LokiMetaSmith/handheld-scanner/Hardware/Power/STEP files/PinHeader_1x08_P2.54mm_Vertical.step

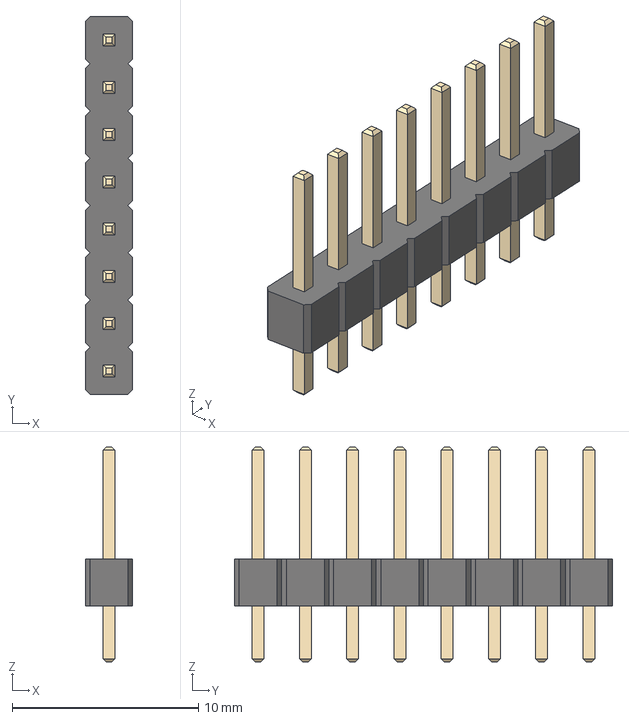
[picture p3: CAD file, 2023-10-03]
Hardware/Power/STEP files/PinHeader_1x08_P2.54mm_Vertical.step
2.54 x 20.3 x 11.5 mm
