LokiMetaSmith/handheld-scanner/Hardware/Power/STEP files/USB4715-GF-A_REVA/USB4715-GF-A_REVA.step

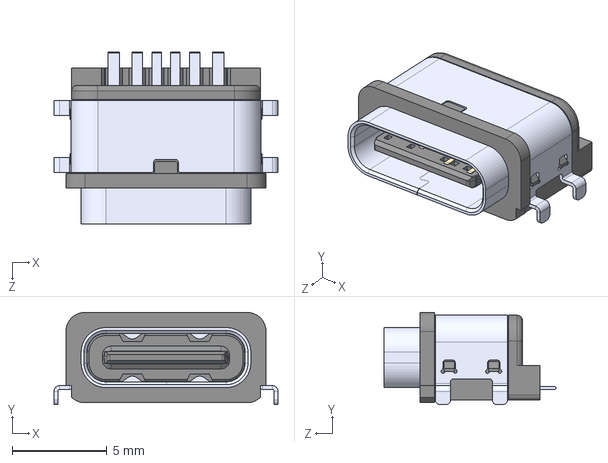
[picture p4: CAD file, 2023-10-03]
Hardware/Power/STEP files/USB4715-GF-A_REVA/USB4715-GF-A_REVA.step
11.8 x 4.86 x 9.05 mm
