LokiMetaSmith/handheld-scanner/Hardware/Power/STEP files/B8B-PH-SM4-TB_LF__SN_.stp

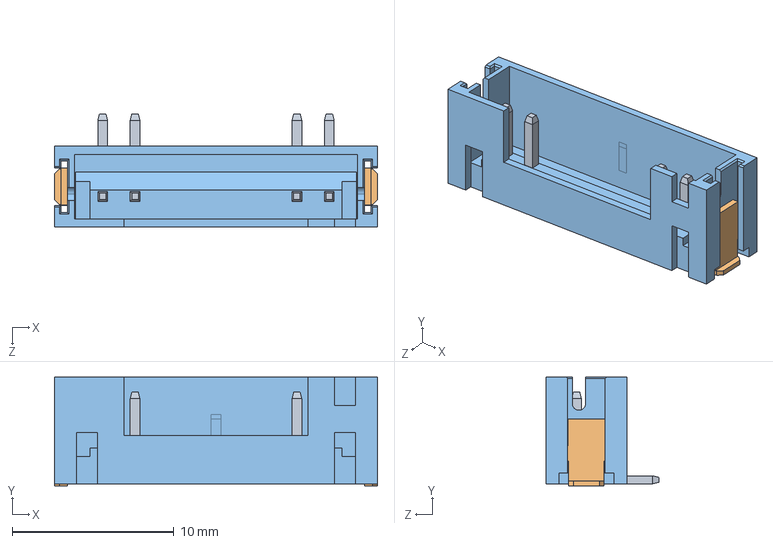
[picture p5: CAD file, 2023-10-03]
Hardware/Power/STEP files/B8B-PH-SM4-TB_LF__SN_.stp
19.9 x 6.73 x 7.00 mm
