LokiMetaSmith/handheld-scanner/Hardware/Power/STEP files/3405 Adafruit HUZZAH32 ESP32 Feather.step

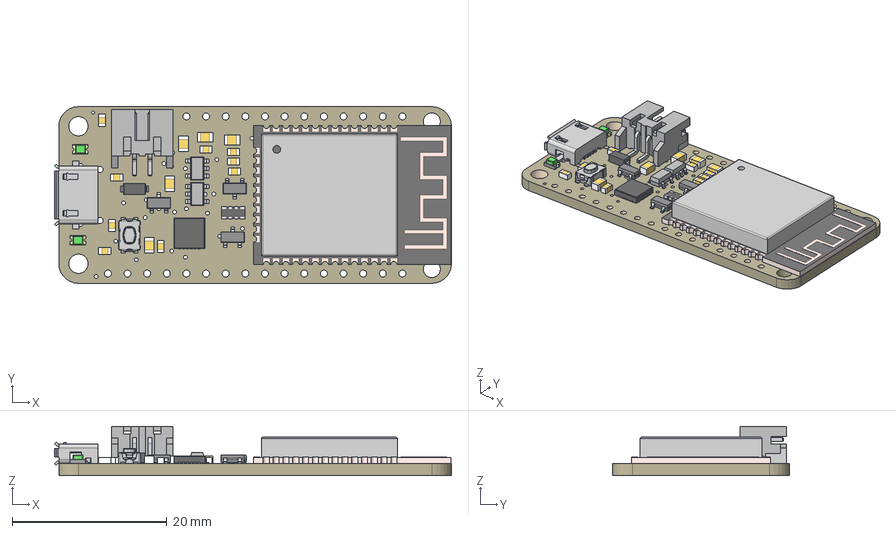
[picture p6: CAD file, 2023-10-03]
Hardware/Power/STEP files/3405 Adafruit HUZZAH32 ESP32 Feather.step
51.4 x 22.9 x 6.37 mm
Board
10uF x 5
4.7K x 9
MCP73831T-2ACI/OT x 2
MBR120
JSTPH
RED x 2
KMR2
CP2104
mmbt2222 x 2
ESP32_WROOM32_SKINNY
DMG3415U
10K
