LokiMetaSmith/handheld-scanner/Hardware/Power/STEP files/keystone-PN2460.STEP

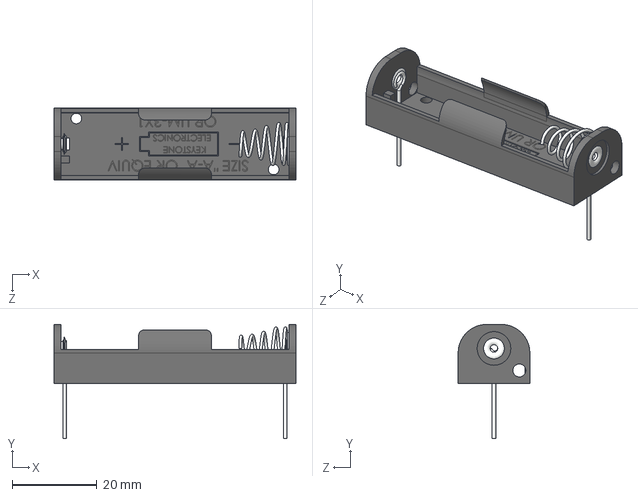
[picture p7: CAD file, 2023-10-03]
Hardware/Power/STEP files/keystone-PN2460.STEP
57.0 x 26.9 x 16.9 mm
