LokiMetaSmith/handheld-scanner/Hardware/Power/STEP files/B2B-EH-A_LF__SN_.stp

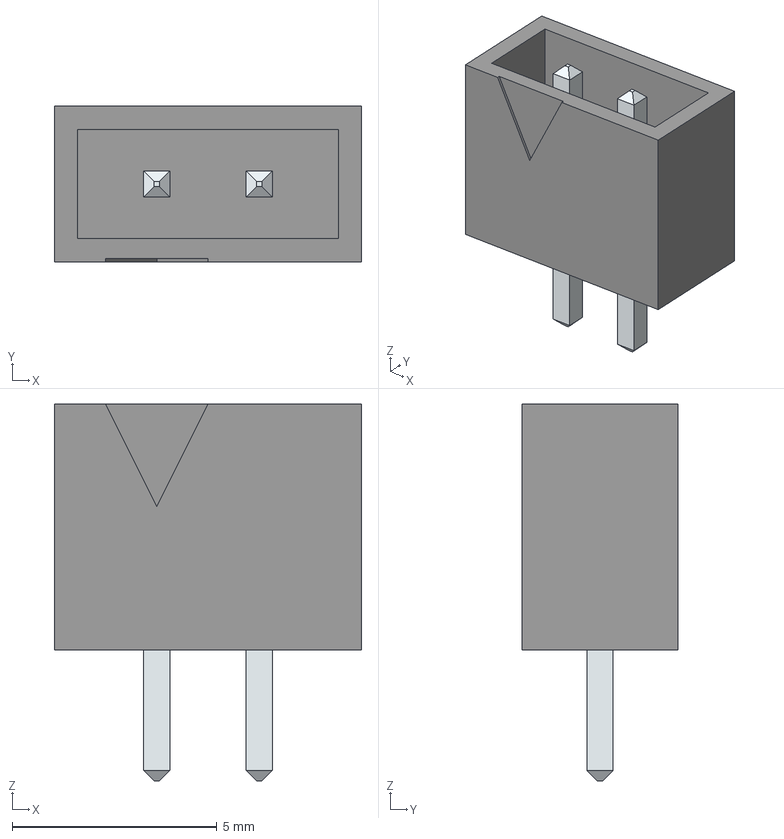
[picture p8: CAD file, 2023-10-03]
Hardware/Power/STEP files/B2B-EH-A_LF__SN_.stp
7.50 x 3.80 x 9.20 mm
LeadsArray
