LokiMetaSmith/handheld-scanner/Hardware/Controller/ControllerBoard.kicad_pcb

## KiCad design Hardware/Controller/ControllerBoard.kicad_pcb (2023-11-27)

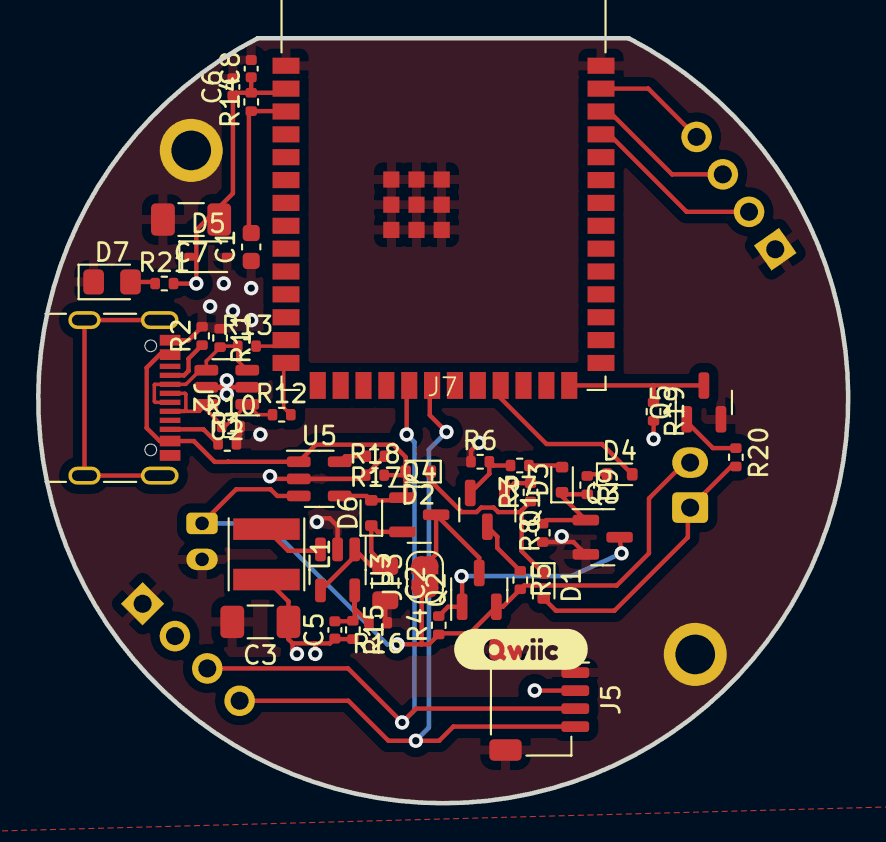
[picture p10: board ControllerBoard.kicad_pcb from above]

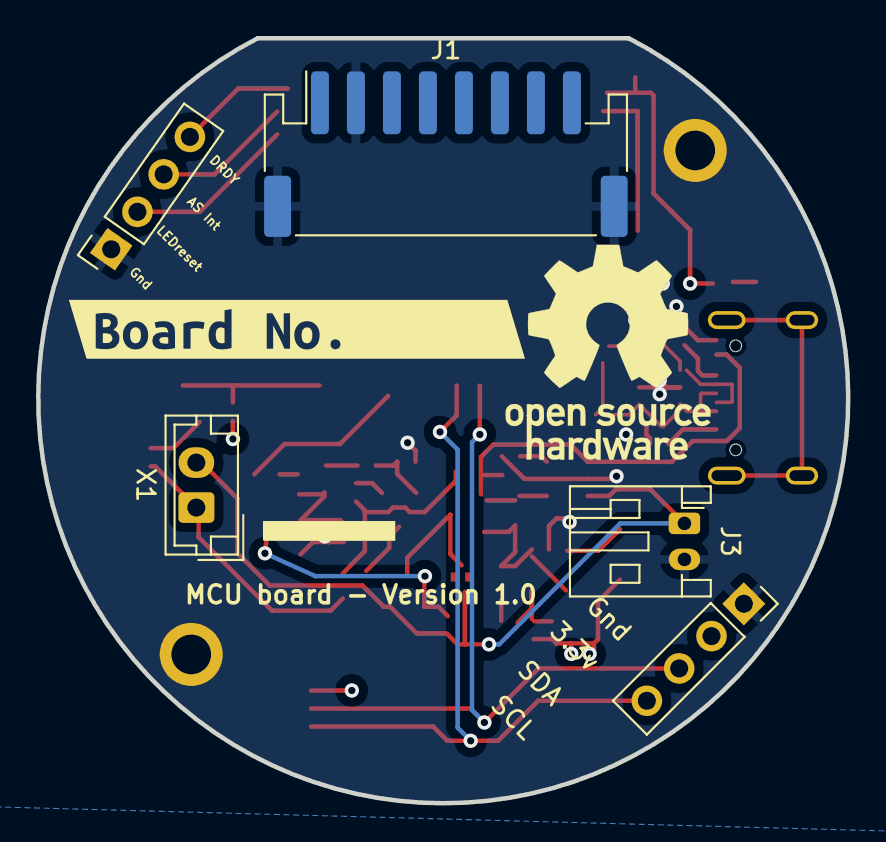
[picture p11: board ControllerBoard.kicad_pcb from below]

Board: 4 copper layers, 45.0 x 42.5 mm, 56 parts (6 on the bottom side), 34 nets.

Parts:
C1: 2u; C_0603_1608Metric
C2: 4.7u; C_0805_2012Metric
C3, C7: 10u; C_1206_3216Metric_Pad1.33x1.80mm_HandSolder
C5: 6.8p; C_0402_1005Metric
C6: 0.01u; C_0402_1005Metric
C8: 0.1u; C_0402_1005Metric
D1, D2, D3, D4, D6: BAS516; D_SOD-523
D5: 3.3v_TVS; D_SOD-323
D7: POWER LED; LED_0805_2012Metric_Pad1.15x1.40mm_HandSolder
J1: Conn_01x08_MountingPin; JST_PH_S8B-PH-SM4-TB_1x08-1MP_P2.00mm_Horizontal
J2: USB_C_Receptacle_USB2.0; USB_C_Receptacle_GCT_USB4105-xx-A_16P_TopMnt_Horizontal
J3: Conn_01x02_Male; JST_PH_S2B-PH-K_1x02_P2.00mm_Horizontal
J5: I2C; JST_SH_SM04B-SRSS-TB_1x04-1MP_P1.00mm_Horizontal
J7: Conn_01x09; round_notch
JP3: Jumper_2_Open; SolderJumper-2_P1.3mm_Bridged2Bar_RoundedPad1.0x1.5mm
L1: 2.2uH; L_Taiyo-Yuden_MD-4040
LOGO1: OSHW-Logo_11.4x12mm_SilkScreen
LOGO2: PlasticScannerLogo
Q1, Q3, Q5: BC818; SOT-23
Q2, Q4: AO3401A; SOT-23
R1, R2, R17: 5.1k; R_0402_1005Metric
R3, R20, R21: 1k; R_0402_1005Metric
R4, R8, R18: 100k; R_0402_1005Metric
R5, R7: 10k; R_0402_1005Metric
R6: 220k; R_0402_1005Metric
R9: 220; R_0402_1005Metric
R10, R11: 15K; R_0402_1005Metric
R12, R13: 27; R_0402_1005Metric
R14, R19: 10K; R_0402_1005Metric
R15: 680k; R_0402_1005Metric
R16: 150K; R_0402_1005Metric
U1: ESP32-S3-WROOM-1
U2: SN65220; SOT-23-6
U3: TLV62569DBV; SOT-23-5
U5: MCP73811T-420I-OT; SOT-23-5
X1: CON_JST_PH_2PIN_MTPH2; JST_EH_B2B-EH-A_1x02_P2.50mm_Vertical
kibuzzard-6398DD41: G***; kibuzzard-6398DD41
kibuzzard-6346913B: G***; kibuzzard-6346913B

Connections:
+3V3: C3.1, C5.1, C6.1, C7.1, C8.1, D5.1 (A1), J5.2, J7.2, L1.2, R14.2, R15.2, R19.2, R21.2, U1.2 (3V3)
/AS7341_INT: J7.7, U1.38 (GPIO2/TOUCH2/ADC1_CH1)
/D+: J2.A6 (D+), J2.B6 (D+), R10.1, R12.1, U2.1, U2.6 (A)
/D-: J2.A7 (D-), J2.B7 (D-), R11.2, R13.1, U2.3, U2.4 (B)
/DRDY_INT: J7.8, U1.39 (GPIO1/TOUCH1/ADC1_CH0)
/EN: C1.2, R14.1, U1.3 (EN)
/KeepAlive: D4.2 (A), U1.23 (GPIO21)
/LED_RESET: J7.6, U1.37 (U0TXD/GPIO43/CLK_OUT1)
/Switched_Power: C2.1, D6.1 (K), Q4.2 (S), U3.1 (EN), U3.4 (VIN)
/Trigger: Q5.2 (E), R19.1, U1.26 (GPIO45)
/Trigger_Wake_Up/VBAT: J3.1, JP3.1 (A), Q2.2 (S), R4.1, R5.2, U5.3 (VBAT), X1.2
/USB_D+: R12.2, U1.14 (GPIO20/U1CTS/ADC2_CH9/CLK_OUT1/USB_D+)
/USB_D-: R13.2, U1.13 (GPIO19/U1RTS/ADC2_CH8/CLK_OUT2/USB_D-)
/USB_pwr: D2.2 (A), D6.2 (A), J2.A4 (VBUS), J2.A9 (VBUS), J2.B4 (VBUS), J2.B9 (VBUS), Q4.1 (G), R18.2, U5.1 (CEN), U5.4 (VDD)
GND: C1.1, C2.2, C3.2, C6.2, C7.2, C8.2, D5.2 (A2), D7.1 (K), J1.2, J1.MP (MountPin), J2.A1 (GND), J2.A12 (GND), J2.B1 (GND), J2.B12 (GND), J3.2, J5.1, J5.MP (Pin_5), J7.1, J7.5, J7.MP, Q3.2 (E), Q5.1 (B), R1.2, R2.2, R6.1, R8.1, R10.2, R11.1, R16.1, R17.1, R18.1, U1.1 (GND), U1.40 (GND), U1.41 (GND), U2.2 (GND), U2.5 (GND), U3.2 (GND), U5.2 (VSS)
unnamed: D1.2 (A), R20.1, X1.1
unnamed: D1.1 (K), D2.1 (K), R3.1
unnamed: D3.2 (A), R7.1
unnamed: D3.1 (K), Q3.1 (B), R8.2, R9.2
unnamed: D4.1 (K), R9.1
unnamed: D7.2 (A), R21.1
unnamed: J2.A5 (CC1), R2.1
unnamed: J2.B5 (CC2), R1.1
unnamed: JP3.2 (B), Q2.3 (D), Q4.3 (D)
unnamed: Q1.1 (B), R3.2
unnamed: Q1.3 (C), R5.1
unnamed: Q1.2 (E), R6.2, R7.2
unnamed: Q2.1 (G), Q3.3 (C), R4.2
unnamed: Q5.3 (C), R20.2
unnamed: C5.2, R15.1, R16.2, U3.5 (FB)
unnamed: L1.1, U3.3 (SW)
unnamed: R17.2, U5.5 (PROG)
SCL: J5.4, J7.4, U1.20 (GPIO12/TOUCH12/ADC2_CH1/FSPICLK/FSPIIO6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)
SDA: J5.3, J7.3, U1.19 (GPIO11/TOUCH11/ADC2_CH0/FSPID/FSPIIO5/S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)
