LokiMetaSmith/handheld-scanner/Hardware/Scanner/RoundScanner.kicad_pcb

## KiCad design Hardware/Scanner/RoundScanner.kicad_pcb (2023-11-27)

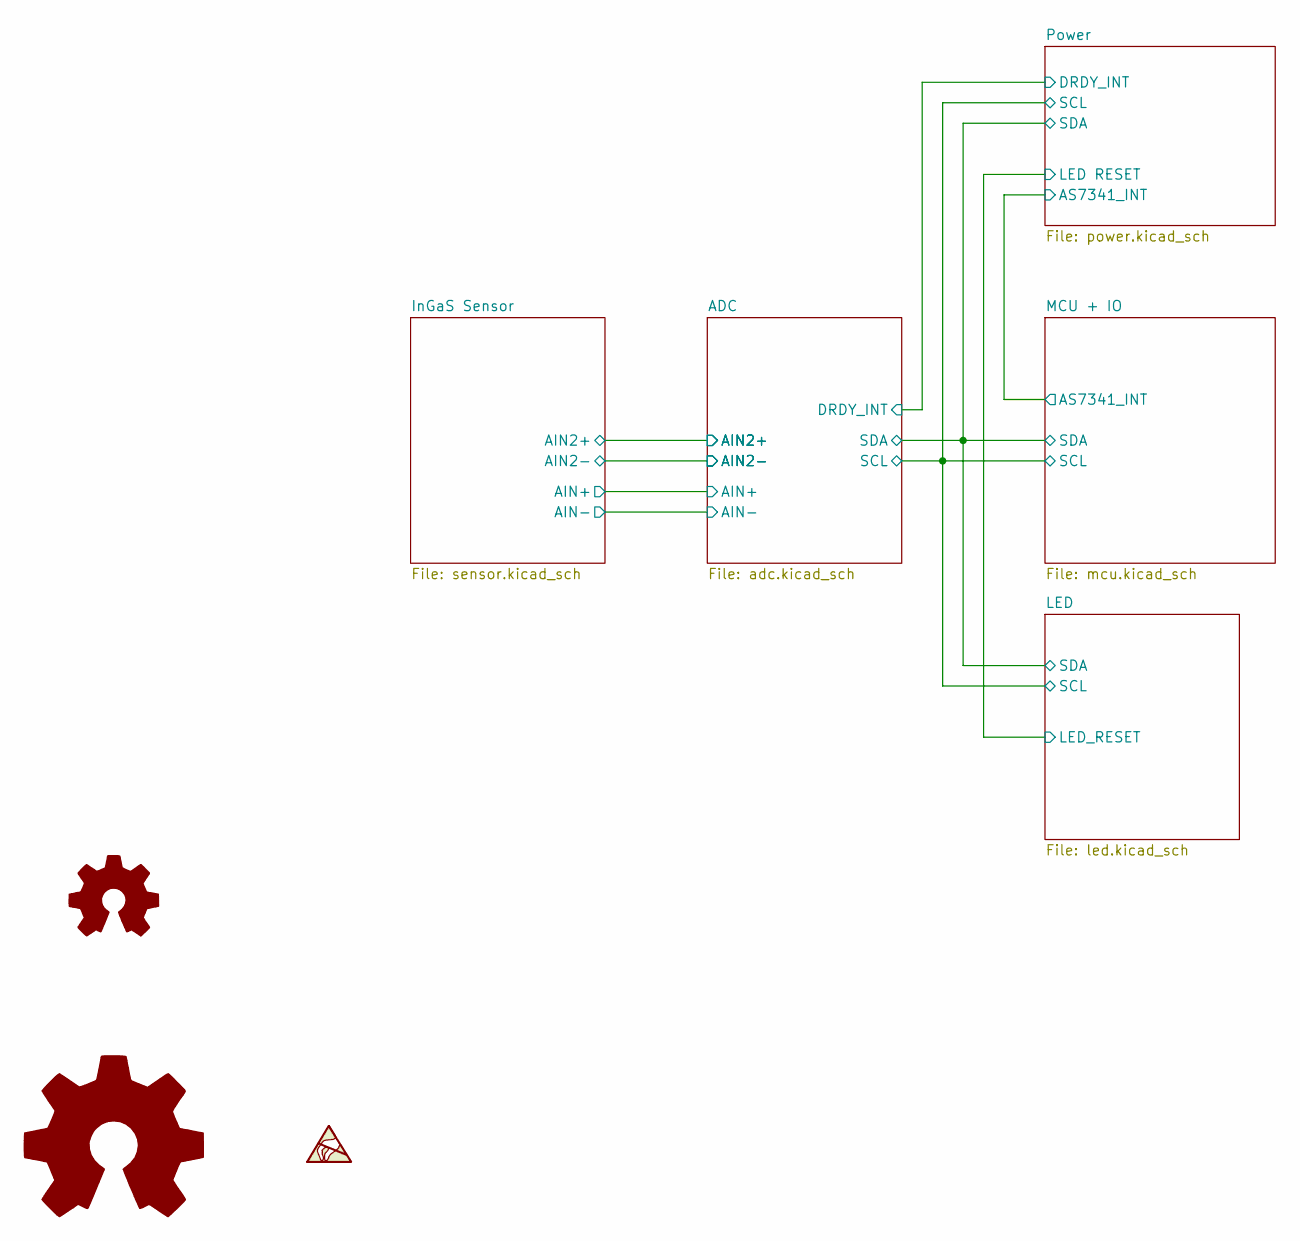
[picture p12: schematic RoundScanner.kicad_sch, Development Board]

Parts:
LOGO1: OSHW-Logo_11.4x12mm_SilkScreen
LOGO2: PlasticScannerLogo

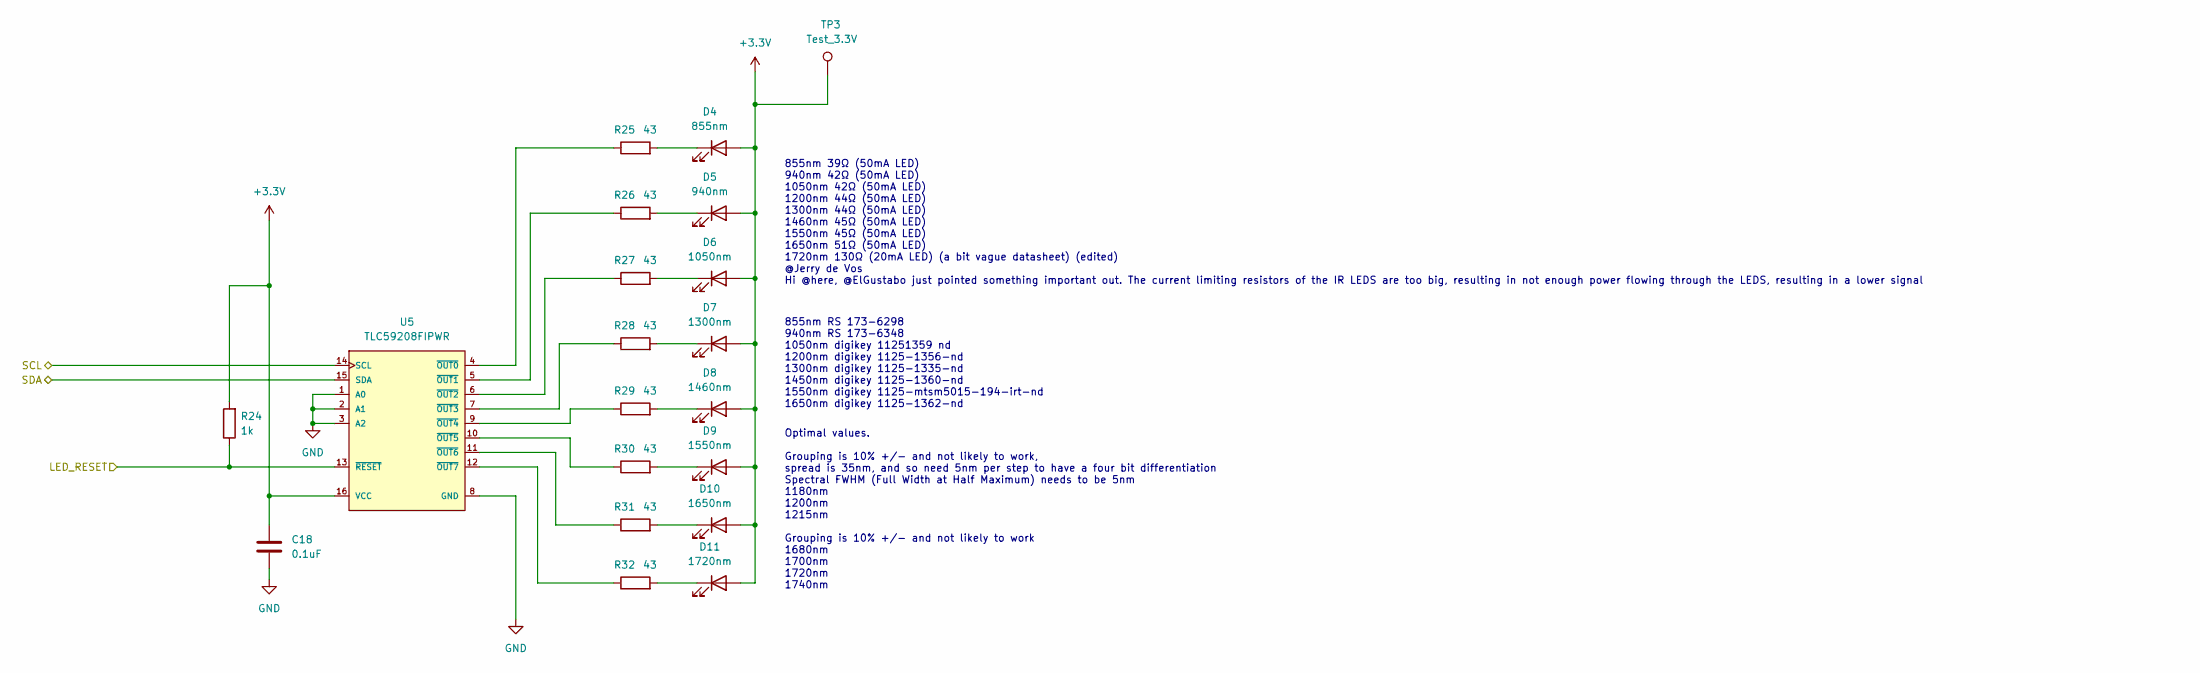
[picture p13: schematic led.kicad_sch, Development Board]

Parts:
C18: 0.1uF; C_0603_1608Metric_Pad1.08x0.95mm_HandSolder; digikey description CAP CER 0.1UF 16V X7R 0603
D4: 855nm; LED_1206_3216Metric_Pad1.42x1.75mm_HandSolder; digikey part number 1516-1269-1-ND
D5: 940nm; LED_1206_3216Metric_Pad1.42x1.75mm_HandSolder; digikey part number 1080-1350-1-ND
D6: 1050nm; LED_1206_3216Metric_Pad1.42x1.75mm_HandSolder; digikey part number 1125-1342-ND
D7: 1300nm; LED_1206_3216Metric_Pad1.42x1.75mm_HandSolder; digikey part number 5242-OIS-1501300N-X-TCT-ND
D8: 1460nm; LED_1206_3216Metric_Pad1.42x1.75mm_HandSolder; digikey part number 1125-MTSM6014-194-IRCT-ND
D9: 1550nm; LED_1206_3216Metric_Pad1.42x1.75mm_HandSolder; digikey part number 5242-OIS-1501550N-X-TCT-ND
D10: 1650nm; LED_1206_3216Metric_Pad1.42x1.75mm_HandSolder; digikey part number 1125-1354-ND
D11: 1720nm; LED_1206_3216Metric_Pad1.42x1.75mm_HandSolder; digikey part number 1125-MTSM0012-194-IRCT-ND
R24: 1k; R_0603_1608Metric_Pad0.98x0.95mm_HandSolder; digikey description RES 1K OHM 1% 1/10W 0603
R25, R26, R27, R28, R29, R30, R31: 43; R_0603_1608Metric_Pad0.98x0.95mm_HandSolder; digikey description RES SMD 43 OHM 5% 1/3W 0603
R32: 43; R_0603_1608Metric_Pad0.98x0.95mm_HandSolder; mouser part number 667-ERJ-3EKF1300V; digikey description RES SMD 43 OHM 5% 1/3W 0603
TP3: Test_3.3V; TestPoint_Pad_D1.5mm
U5: TLC59208FIPWR; SOP65P640X120-16N; digikey description TLC59208FIPWR

Connections:
/LED/LED_RESET: R24.1, U5.13 (~RESET); also elsewhere on the board
GND: C18.2, U5.1 (A0), U5.2 (A1), U5.3 (A2), U5.8 (GND); also elsewhere on the board
unnamed: D4.1 (K), R25.2
unnamed: D5.1 (K), R26.2
unnamed: D6.1 (K), R27.2
unnamed: D7.1 (K), R28.2
unnamed: D8.1 (K), R29.2
unnamed: D9.1 (K), R30.2
unnamed: D10.1 (K), R31.2
unnamed: D11.1 (K), R32.2
unnamed: R25.1, U5.4 (~OUT0)
unnamed: R26.1, U5.5 (~OUT1)
unnamed: R27.1, U5.6 (~OUT2)
unnamed: R28.1, U5.7 (~OUT3)
unnamed: R29.1, U5.9 (~OUT4)
unnamed: R30.1, U5.10 (~OUT5)
unnamed: R31.1, U5.11 (~OUT6)
unnamed: R32.1, U5.12 (~OUT7)
SCL: U5.14 (SCL); also elsewhere on the board
SDA: U5.15 (SDA); also elsewhere on the board

Notes on the sheet:
855nm RS 173-6298 940nm RS 173-6348 1050nm digikey 11251359 nd 1200nm digikey 1125-1356-nd 1300nm digikey 1125-1335-nd 1450nm digikey 1125-1360-nd 1550nm digikey 1125-mtsm5015-194-irt-nd 1650nm digikey 1125-1362-nd
855nm 39Ω (50mA LED) 940nm 42Ω (50mA LED) 1050nm 42Ω (50mA LED) 1200nm 44Ω (50mA LED) 1300nm 44Ω (50mA LED) 1460nm 45Ω (50mA LED) 1550nm 45Ω (50mA LED) 1650nm 51Ω (50mA LED) 1720nm 130Ω (20mA LED) (a bit vague datasheet) (edited) @Jerry de Vos Hi @here, @ElGustabo just pointed something important o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
Optimal values. Grouping is 10% +/- and not likely to work, spread is 35nm, and so need 5nm per step to have a four bit differentiation Spectral FWHM (Full Width at Half Maximum) needs to be 5nm 1180nm 1200nm 1215nm Grouping is 10% +/- and not likely to work 1680nm 1700nm 1720nm 1740nm

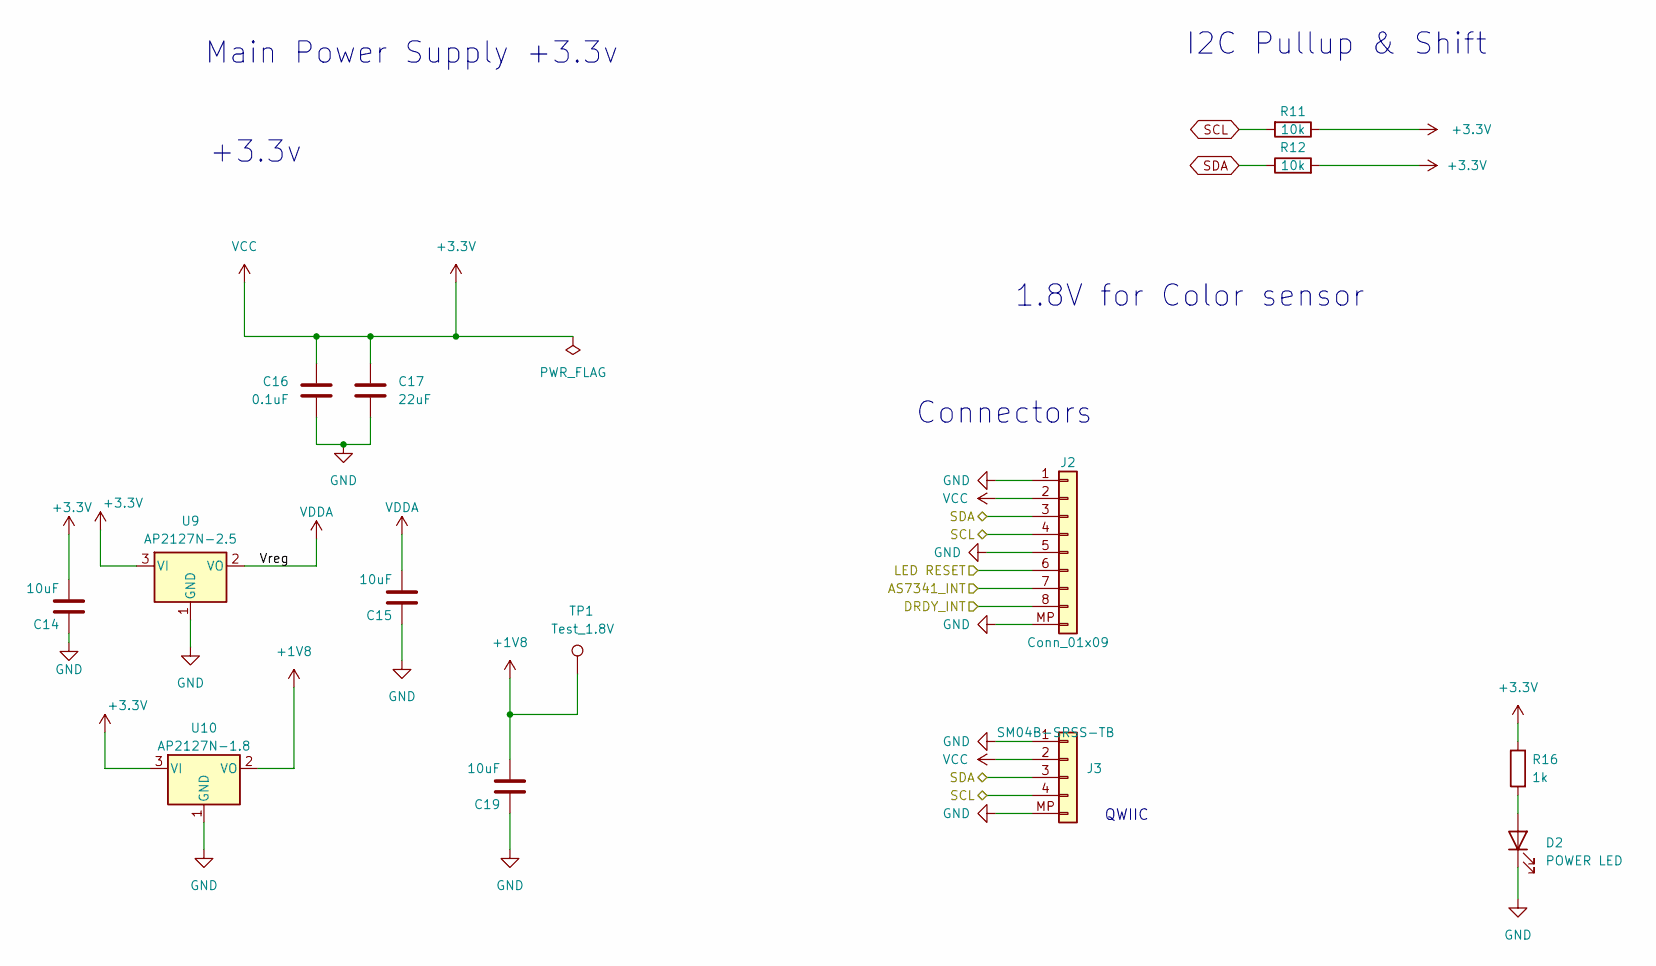
[picture p14: schematic power.kicad_sch, Development Board]

Parts:
C14, C15, C19: 10uF; C_0603_1608Metric_Pad1.08x0.95mm_HandSolder; digikey description CAP CER 10UF 6.3V X5R 0603
C16: 0.1uF; C_0603_1608Metric_Pad1.08x0.95mm_HandSolder; digikey description CAP CER 0.1UF 16V X7R 0603
C17: 22uF; C_0603_1608Metric_Pad1.08x0.95mm_HandSolder; digikey description CAP CER 22UF 6.3V X5R 0603
D2: POWER LED; LED_0805_2012Metric_Pad1.15x1.40mm_HandSolder; digikey description LED RED CLEAR 1206 SMD
J2: Conn_01x09; round_notch
J3: SM04B-SRSS-TB; JST_SH_SM04B-SRSS-TB_1x04-1MP_P1.00mm_Horizontal; digikey description SM04B-SRSS-TB
R11, R12: 10k; R_0603_1608Metric_Pad0.98x0.95mm_HandSolder; mouser part number 279-CRGH0603J10K; mouser description CRGH0603J10K
R16: 1k; R_0603_1608Metric_Pad0.98x0.95mm_HandSolder; digikey description RES 1K OHM 1% 1/10W 0603
TP1: Test_1.8V; TestPoint_Pad_D1.5mm
U9: AP2127N-2.5; SOT-23; digikey description IC REG LINEAR 2.5V 300MA SOT23
U10: AP2127N-1.8; SOT-23; digikey description IC REG LINEAR 1.8V 300MA SOT23-3

Connections:
+1V8: C19.2, TP1.1, U10.2 (VO); also elsewhere on the board
/ADC/DRDY_INT: J2.8; also elsewhere on the board
/LED/LED_RESET: J2.6; also elsewhere on the board
/MCU + IO/AS7341_INT: J2.7; also elsewhere on the board
GND: C14.1, C15.1, C16.1, C17.2, C19.1, D2.1 (K), J2.1, J2.5, J2.MP, J3.1, J3.MP (Pin_5), U9.1 (GND), U10.1 (GND); also elsewhere on the board
unnamed: D2.2 (A), R16.2
SCL: J2.4, J3.4, R11.2; also elsewhere on the board
SDA: J2.3, J3.3, R12.1; also elsewhere on the board
VDDA: C15.2, U9.2 (VO); also elsewhere on the board

Notes on the sheet:
Connectors
QWIIC
Main Power Supply +3.3v
1.8V for Color sensor
+3.3v
I2C Pullup & Shift

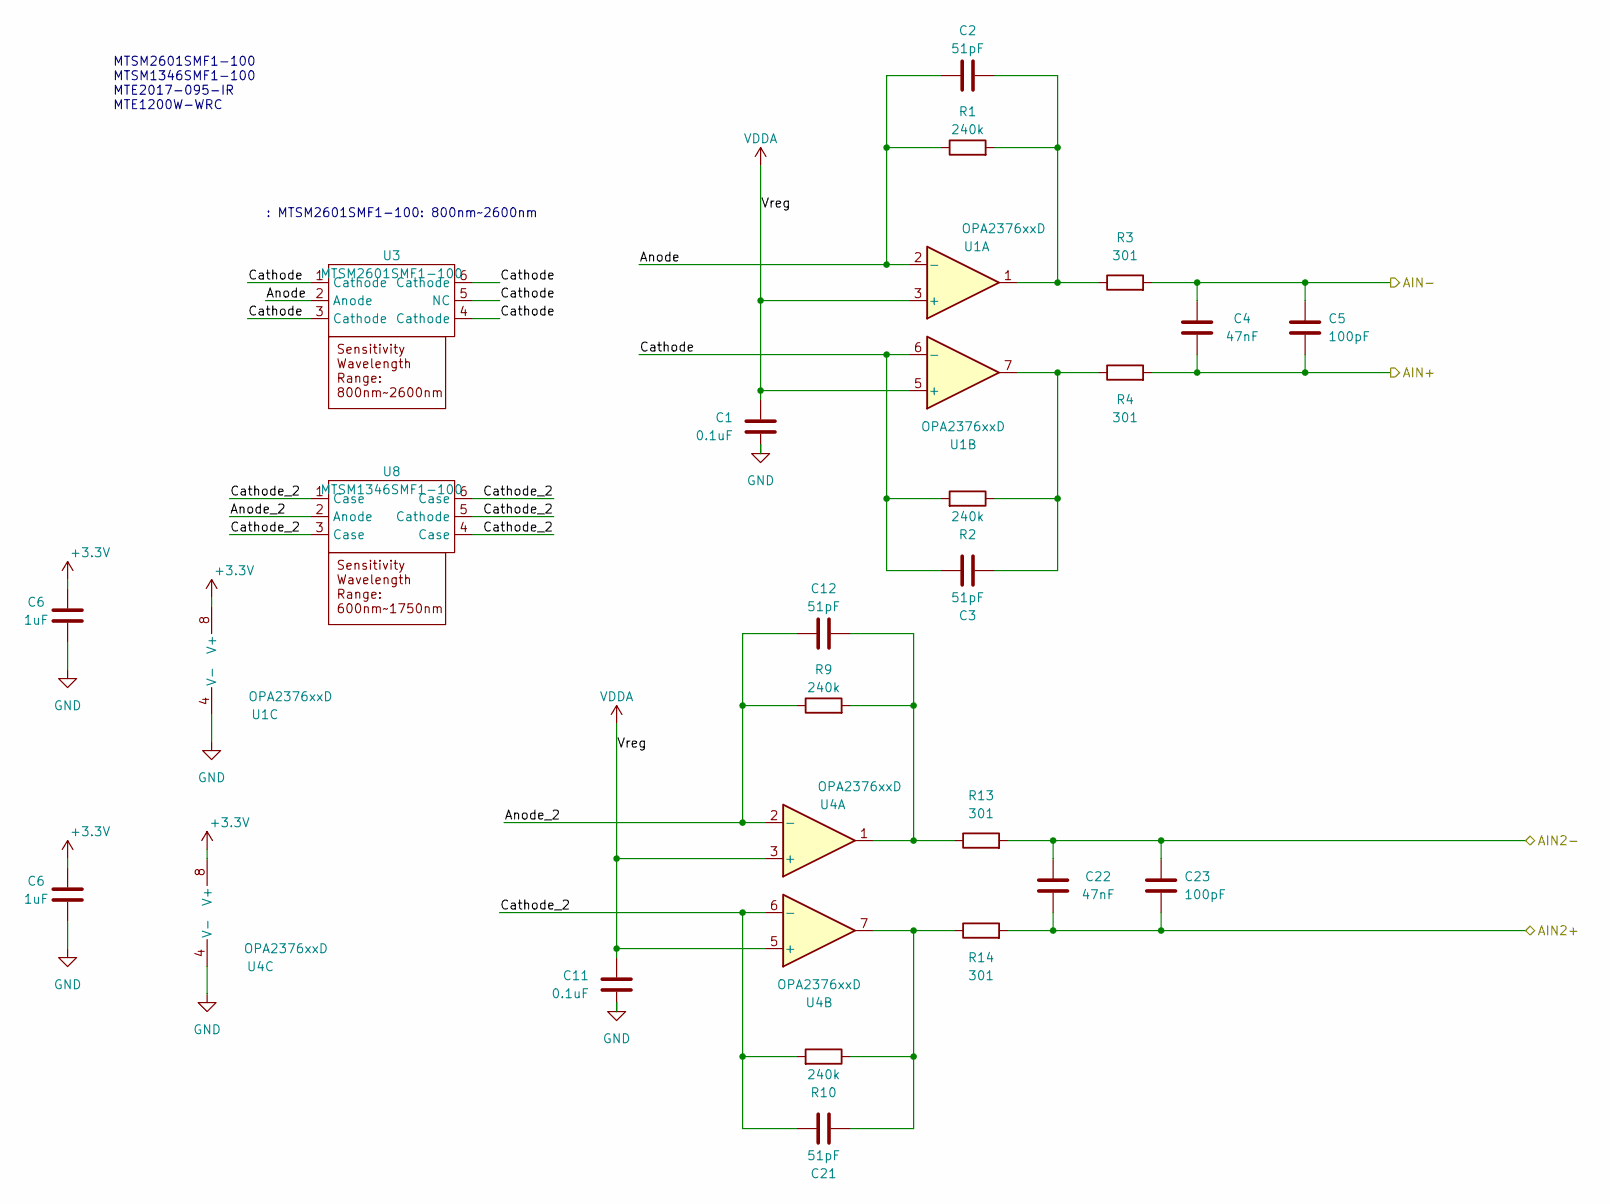
[picture p15: schematic sensor.kicad_sch, Development Board]

Parts:
C1, C11: 0.1uF; C_0603_1608Metric_Pad1.08x0.95mm_HandSolder; digikey description CAP CER 0.1UF 16V X7R 0603
C2, C3, C12, C21: 51pF; C_0603_1608Metric_Pad1.08x0.95mm_HandSolder; digikey description CAP CER 51PF 50V C0G/NP0 0603
C4, C22: 47nF; C_0603_1608Metric_Pad1.08x0.95mm_HandSolder; digikey description CAP CER 0.047UF 50V X7R 0603
C5, C23: 100pF; C_0603_1608Metric_Pad1.08x0.95mm_HandSolder; digikey description CAP CER 100PF 50V C0G/NP0 0603
C6: 1uF; C_0603_1608Metric_Pad1.08x0.95mm_HandSolder; digikey description CAP CER 1UF 16V X7R 0603
R1, R2, R9, R10: 240k; R_0603_1608Metric_Pad0.98x0.95mm_HandSolder; mouser part number 667-ERJ-3EKF2403V; mouser description ERJ-3EKF2403V
R3, R4, R13, R14: 301; R_0603_1608Metric_Pad0.98x0.95mm_HandSolder; mouser part number 667-ERJ-3EKF3010V; mouser description ERJ-3EKF3010V
U1, U4: OPA2376xxD; SOIC127P599X175-8N; mouser part number 595-OPA2376AIDR; digikey part number 296-26263-5-ND
U3: MTSM2601SMF1-100; digikey description SENSOR PHOTODIODE 800-2600NM SMD
U8: MTSM1346SMF1-100; digikey description SENSOR PHOTODIODE 1300NM 6SMD

Connections:
/ADC/AIN2+: C22.1, C23.2, R14.2; also elsewhere on the board
/ADC/AIN2-: C22.2, C23.1, R13.2; also elsewhere on the board
/ADC/AIN+: C4.1, C5.2, R4.2; also elsewhere on the board
/ADC/AIN-: C4.2, C5.1, R3.2; also elsewhere on the board
/InGaS Sensor/Anode: C2.1, R1.1, U1.2 (-), U3.2 (Anode)
/InGaS Sensor/Anode_2: C12.1, R9.1, U4.2 (-), U8.2 (Anode)
/InGaS Sensor/Cathode: C3.1, R2.2, U1.6 (-), U3.1 (Cathode), U3.3 (Cathode), U3.4 (Cathode), U3.5 (NC), U3.6 (Cathode)
/InGaS Sensor/Cathode_2: C21.1, R10.2, U4.6 (-), U8.1 (Case), U8.3 (Case), U8.4 (Case), U8.5 (Cathode), U8.6 (Case)
GND: C1.1, C6.1, C11.1, U1.4 (V-), U4.4 (V-); also elsewhere on the board
unnamed: C2.2, R1.2, R3.1, U1.1
unnamed: C3.2, R2.1, R4.1, U1.7
unnamed: C12.2, R9.2, R13.1, U4.1
unnamed: C21.2, R10.1, R14.1, U4.7
VDDA: C1.2, C11.2, U1.3 (+), U1.5 (+), U4.3 (+), U4.5 (+); also elsewhere on the board

Notes on the sheet:
MTSM2601SMF1-100 MTSM1346SMF1-100 MTE2017-095-IR MTE1200W-WRC
: MTSM2601SMF1-100: 800nm~2600nm

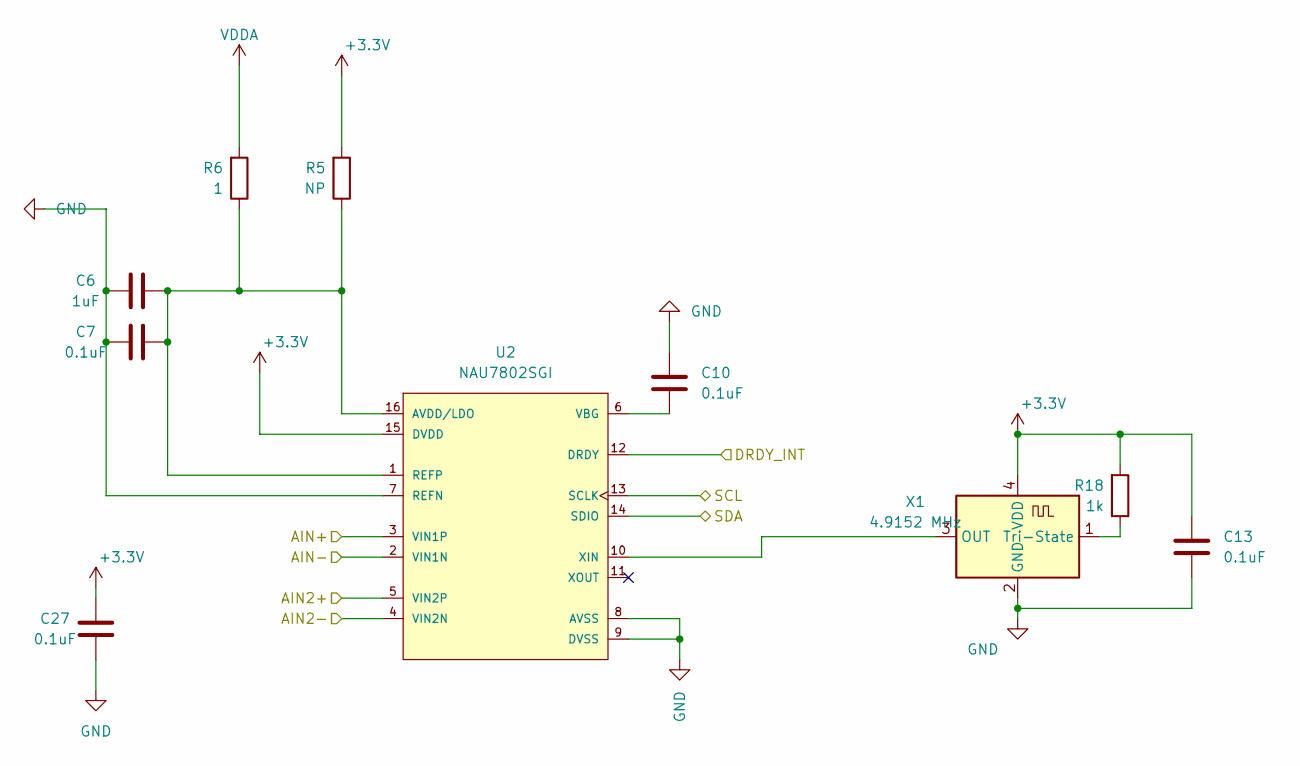
[picture p16: schematic adc.kicad_sch, Development Board]

Parts:
C6: 1uF; C_0603_1608Metric_Pad1.08x0.95mm_HandSolder; digikey description CAP CER 1UF 16V X7R 0603
C7, C10, C13, C27: 0.1uF; C_0603_1608Metric_Pad1.08x0.95mm_HandSolder; digikey description CAP CER 0.1UF 16V X7R 0603
R5: NP; R_0603_1608Metric_Pad0.98x0.95mm_HandSolder
R6: 1; R_0603_1608Metric_Pad0.98x0.95mm_HandSolder; mouser part number 652-CHP0603QFW-1R00E; mouser description CHP0603QFW-1R00ELF
R18: 1k; R_0603_1608Metric_Pad0.98x0.95mm_HandSolder; digikey description RES 1K OHM 1% 1/10W 0603
U2: NAU7802SGI; Nuvoton-NAU7802SGI; digikey description IC ADC 24BIT I2C/SRL 16-SOP
X1: 4.9152 MHz; Oscillator_SMD_ECS_2520MV-xxx-xx-4Pin_2.5x2.0mm; digikey description XTAL OSC XO 4.9152MHZ CMOS SMD

Connections:
/ADC/AIN2+: U2.5 (VIN2P); also elsewhere on the board
/ADC/AIN2-: U2.4 (VIN2N); also elsewhere on the board
/ADC/AIN+: U2.3 (VIN1P); also elsewhere on the board
/ADC/AIN-: U2.2 (VIN1N); also elsewhere on the board
/ADC/DRDY_INT: U2.12 (DRDY); also elsewhere on the board
GND: C6.1, C7.1, C10.1, C13.2, C27.1, U2.7 (REFN), U2.8 (AVSS), U2.9 (DVSS), X1.2 (GND); also elsewhere on the board
unnamed: C10.2, U2.6 (VBG)
unnamed: U2.10 (XIN), X1.3 (OUT)
unnamed: R18.1, X1.1 (Tri-State)
SCL: U2.13 (SCLK); also elsewhere on the board
SDA: U2.14 (SDIO); also elsewhere on the board
VDDA: R6.2; also elsewhere on the board

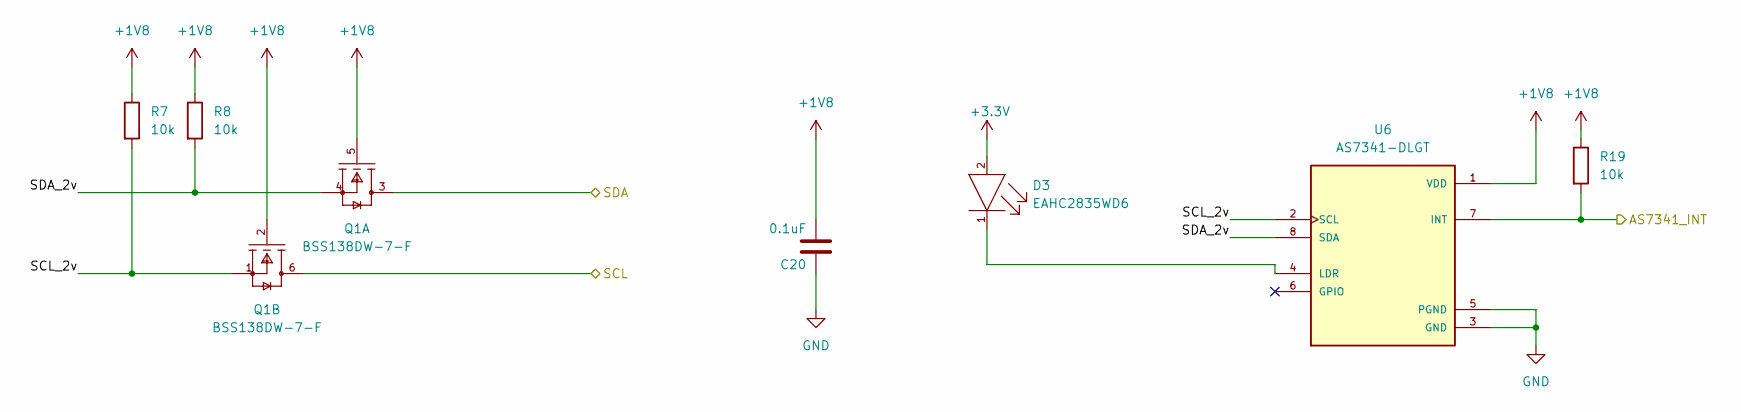
[picture p17: schematic mcu.kicad_sch, Development Board]

Parts:
C20: 0.1uF; C_0603_1608Metric_Pad1.08x0.95mm_HandSolder; digikey description CAP CER 0.1UF 16V X7R 0603
D3: EAHC2835WD6; Everlight-EAHC2835WD6-MFG; mouser part number 638-EAHC2835WD6; digikey description LED COOL WHITE 6500K 2SMD
Q1: BSS138DW-7-F; Diodes_Inc._-_BSS138DW-7-F-A; mouser part number 621-BSS138DW-F; digikey description MOSFET 2N-CH 50V 0.2A SC70-6
R7, R8, R19: 10k; R_0603_1608Metric_Pad0.98x0.95mm_HandSolder; mouser part number 279-CRGH0603J10K; mouser description CRGH0603J10K
U6: AS7341-DLGT; PSON80P310X200X110-8N; PARTREV V3; digikey description SENSOR OPT AMBIENT 8OLGA

Connections:
+1V8: C20.2, Q1.2 (G2), Q1.5 (G1), R7.1, R8.1, R19.1, U6.1 (VDD); also elsewhere on the board
/MCU + IO/AS7341_INT: R19.2, U6.7 (INT); also elsewhere on the board
/MCU + IO/SCL_2v: Q1.1 (S2), R7.2, U6.2 (SCL)
/MCU + IO/SDA_2v: Q1.4 (S1), R8.2, U6.8 (SDA)
GND: C20.1, U6.3 (GND), U6.5 (PGND); also elsewhere on the board
unnamed: D3.1 (CATHODE), U6.4 (LDR)
SCL: Q1.6 (D2); also elsewhere on the board
SDA: Q1.3 (D1); also elsewhere on the board

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
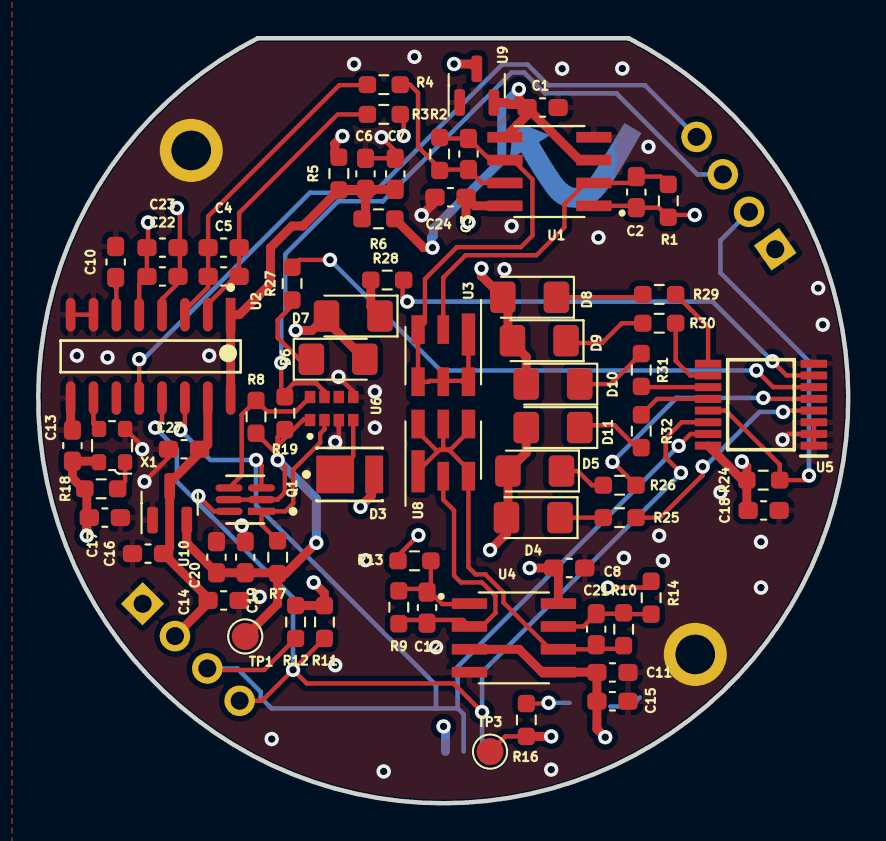
[picture p18: board RoundScanner.kicad_pcb from above]

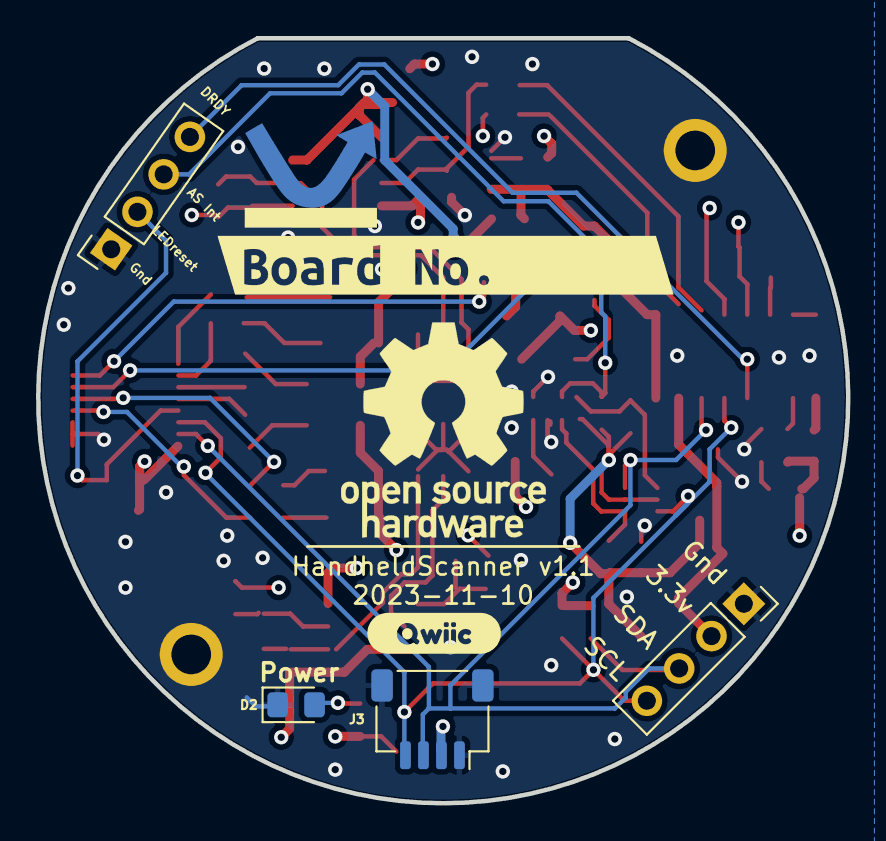
[picture p19: board RoundScanner.kicad_pcb from below]

Board: 4 copper layers, 45.0 x 42.5 mm, 79 parts (6 on the bottom side), 45 nets.

Other parts of the board:
C8, C24: 1uF; C_0603_1608Metric_Pad1.08x0.95mm_HandSolder
kibuzzard-6398DD41: G***; kibuzzard-6398DD41
kibuzzard-6346913B: G***; kibuzzard-6346913B

Their connections:
GND: C8.1, C24.1; also elsewhere on the board
