LokiMetaSmith/handheld-scanner/Hardware/Power/Power.kicad_pcb

## KiCad design Hardware/Power/Power.kicad_pcb (2023-10-03)

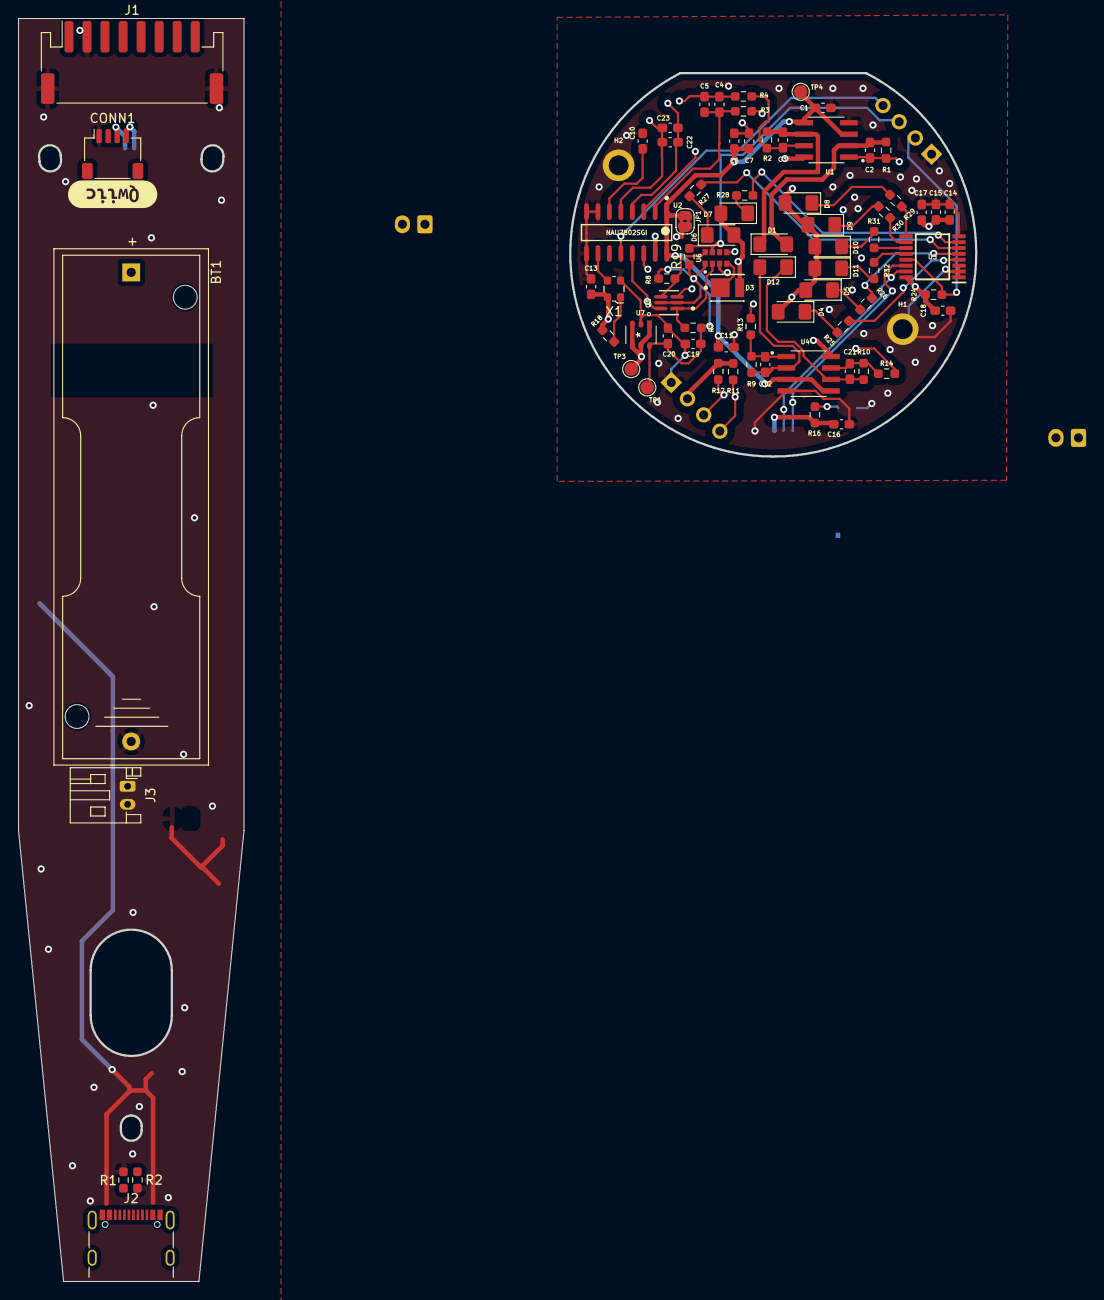
[picture p20: board Power.kicad_pcb from above]

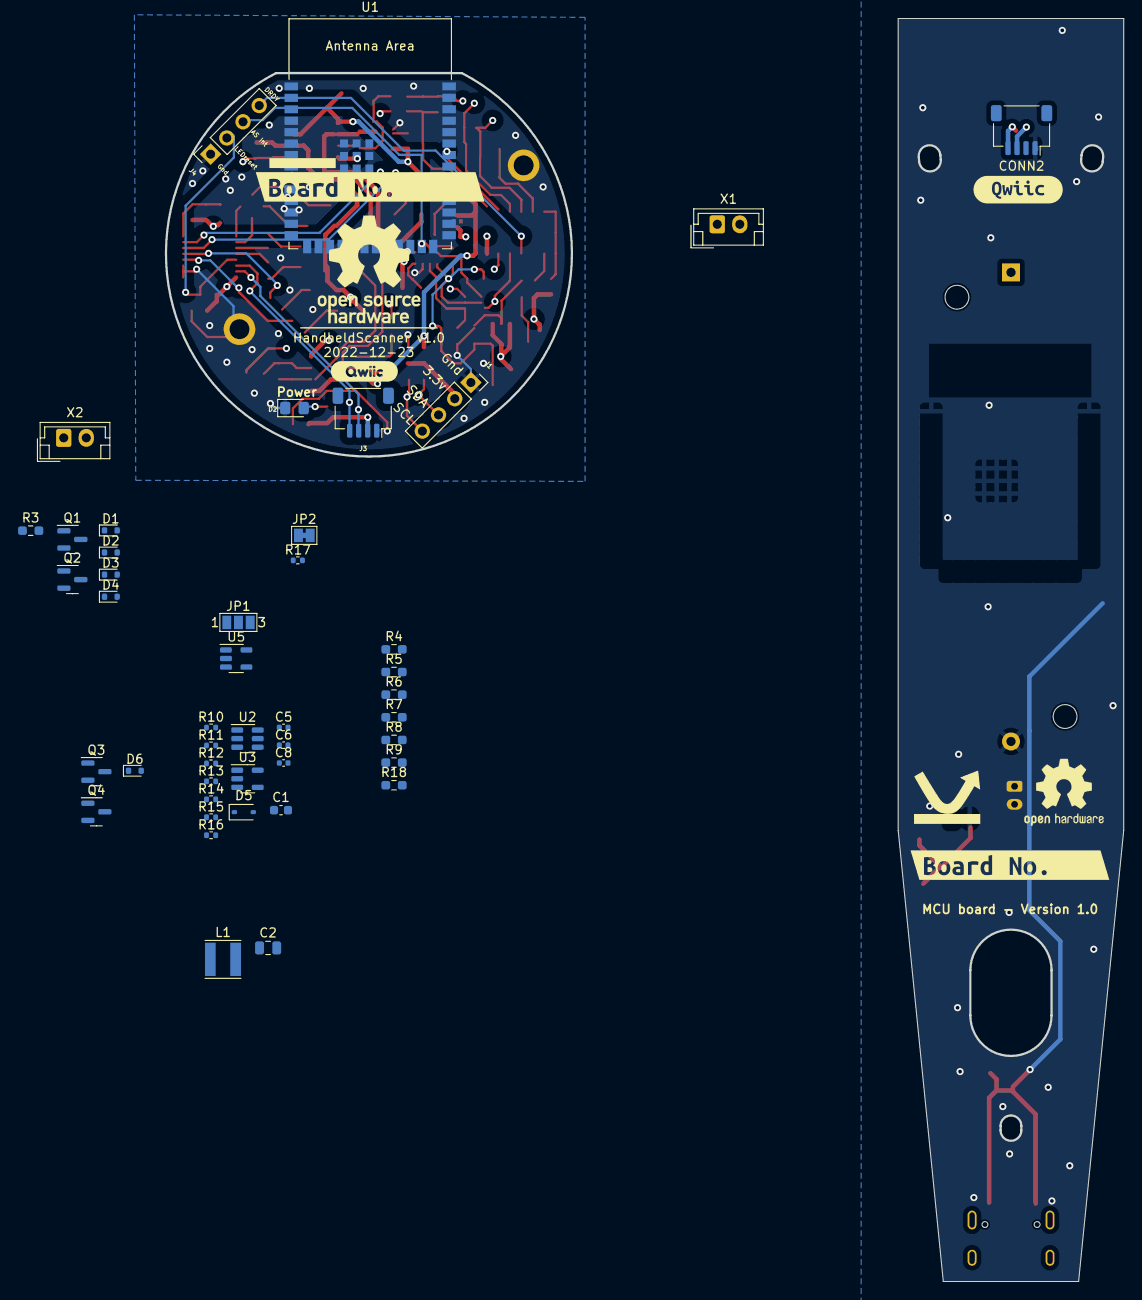
[picture p21: board Power.kicad_pcb from below]

Board: 4 copper layers, 106.2 x 140.0 mm, 131 parts (53 on the bottom side), 33 nets.

Parts:
BT1: Battery; BatteryHolder_Keystone_2460_1xAA
C1, C11, C16, C18: 100nF; C_0603_1608Metric_Pad1.08x0.95mm_HandSolder
C1#2: 2u; C_0603_1608Metric
C2, C3, C12, C21: 51pF; C_0603_1608Metric_Pad1.08x0.95mm_HandSolder
C2#2: 4.7u; C_0805_2012Metric
C4, C22: 47nF; C_0603_1608Metric_Pad1.08x0.95mm_HandSolder
C5, C23: 100pF; C_0603_1608Metric_Pad1.08x0.95mm_HandSolder
C5#2: 6.8p; C_0402_1005Metric
C6: 1uF; C_0603_1608Metric_Pad1.08x0.95mm_HandSolder
C6#2: 0.01u; C_0402_1005Metric
C7, C10, C13, C20: 0.1uF; C_0603_1608Metric_Pad1.08x0.95mm_HandSolder
C8: 0.1u; C_0402_1005Metric
C14, C15, C19: 10uF; C_0603_1608Metric_Pad1.08x0.95mm_HandSolder
C17: 22uF; C_0603_1608Metric_Pad1.08x0.95mm_HandSolder
CONN1, CONN2: STEMMA_I2C_QT; JST_SH_SM04B-SRSS-TB_1x04-1MP_P1.00mm_Horizontal
D1, D12: 0090-3111-185; D_1206_3216Metric_Pad1.42x1.75mm_HandSolder
D1#2, D2#2, D3#2, D4#2, D6#2: BAS516; D_SOD-523
D2: POWER LED; LED_0805_2012Metric_Pad1.15x1.40mm_HandSolder
D3: EAHC2835WD6; Everlight-EAHC2835WD6-MFG
D4: 855nm; LED_1206_3216Metric_Pad1.42x1.75mm_HandSolder
D5: 940nm; LED_1206_3216Metric_Pad1.42x1.75mm_HandSolder
D5#2: 3.3v_TVS; D_SOD-323
D6: 1050nm; LED_1206_3216Metric_Pad1.42x1.75mm_HandSolder
D7: 1300nm; LED_1206_3216Metric_Pad1.42x1.75mm_HandSolder
D8: 1460nm; LED_1206_3216Metric_Pad1.42x1.75mm_HandSolder
D9: 1550nm; LED_1206_3216Metric_Pad1.42x1.75mm_HandSolder
D10: 1650nm; LED_1206_3216Metric_Pad1.42x1.75mm_HandSolder
D11: 1720nm; LED_1206_3216Metric_Pad1.42x1.75mm_HandSolder
H1, H2: MountingHole; MountingHole_2.2mm_M2_ISO7380_Pad
J1: Conn_01x08_MountingPin; JST_PH_S8B-PH-SM4-TB_1x08-1MP_P2.00mm_Horizontal
J1#2: I2C ThroughHole; PinSocket_1x04_P2.54mm_Vertical
J2: USB_C_Receptacle_USB2.0; USB_C_Receptacle_GCT_USB4105-xx-A_16P_TopMnt_Horizontal
J3: Conn_01x02_Male; JST_PH_S2B-PH-K_1x02_P2.00mm_Horizontal
J3#2: I2C; JST_SH_SM04B-SRSS-TB_1x04-1MP_P1.00mm_Horizontal
J4: Interface; PinSocket_1x04_P2.54mm_Vertical
JP1: Jumper_2_Bridged; SolderJumper-2_P1.3mm_Bridged2Bar_RoundedPad1.0x1.5mm
JP1#2: SolderJumper_3_Open; SolderJumper-3_P1.3mm_Open_Pad1.0x1.5mm_NumberLabels
JP2: SolderJumper_2_Bridged; SolderJumper-2_P1.3mm_Bridged_Pad1.0x1.5mm
L1: 2.2uH; L_Taiyo-Yuden_MD-4040
LOGO1: OSHW-Logo_11.4x12mm_SilkScreen
LOGO2: PlasticScannerLogo
OSH logo: OSHW-Logo2_9.8x8mm_SilkScreen
PlasticScannerLogo: PlasticScannerLogo
Q1: BSS138DW-7-F; Diodes_Inc._-_BSS138DW-7-F-A
Q1#2, Q3: BC818; SOT-23
Q2, Q4: AO3401A; SOT-23
R1, R2#2: 5.1k; R_0603_1608Metric_Pad0.98x0.95mm_HandSolder
R1#2, R2, R9, R10: 240k; R_0603_1608Metric_Pad0.98x0.95mm_HandSolder
R3, R4, R13, R14: 301; R_0603_1608Metric_Pad0.98x0.95mm_HandSolder
R3#2, R18, R24: 1k; R_0603_1608Metric_Pad0.98x0.95mm_HandSolder
R4#2, R8#2, R18#2: 100k; R_0603_1608Metric_Pad0.98x0.95mm_HandSolder
R5, R7, R7#2, R8, R11, R12, R19: 10k; R_0603_1608Metric_Pad0.98x0.95mm_HandSolder
R6: 220k; R_0603_1608Metric_Pad0.98x0.95mm_HandSolder
R9#2: 220; R_0603_1608Metric_Pad0.98x0.95mm_HandSolder
R10#2, R11#2: 15K; R_0402_1005Metric
R12#2, R13#2: 27; R_0402_1005Metric
R14#2: 10K; R_0402_1005Metric
R15: 680k; R_0402_1005Metric
R16, R26, R29, R30: 150; R_0603_1608Metric_Pad0.98x0.95mm_HandSolder
R16#2: 150K; R_0402_1005Metric
R17: 5.1k; R_0402_1005Metric
R25: 56; R_0603_1608Metric_Pad0.98x0.95mm_HandSolder
R27, R28: 240; R_0603_1608Metric_Pad0.98x0.95mm_HandSolder
R31: 40; R_0603_1608Metric_Pad0.98x0.95mm_HandSolder
R32: 130; R_0603_1608Metric_Pad0.98x0.95mm_HandSolder
TP1: Test_1.8V; TestPoint_Pad_D1.5mm
TP3: Test_3.3V; TestPoint_Pad_D1.5mm
TP4: Test_2.5V; TestPoint_Pad_D1.5mm
U1, U4: OPA2376xxD; SOIC127P599X175-8N
U1#2: ESP32-S3-WROOM-1
U2: NAU7802SGI; Nuvoton-NAU7802SGI
U2#2: SN65220; SOT-23-6
U3: TLV62569DBV; SOT-23-5
U5: TLC59208FIPWR; SOP65P640X120-16N
U5#2: MCP73811T-420I-OT; SOT-23-5
U6: AS7341-DLGT; PSON80P310X200X110-8N
U7: AP7312-1833W6-7
X1: 4.9152 MHz; Oscillator_SMD_ECS_2520MV-xxx-xx-4Pin_2.5x2.0mm
X1#2, X2: CON_JST_PH_2PIN_MTPH2; JST_EH_B2B-EH-A_1x02_P2.50mm_Vertical
kibuzzard-6398DD41: G***; kibuzzard-6398DD41
kibuzzard-639881D9: G***; kibuzzard-639881D9
kibuzzard-6346913B: G***; kibuzzard-6346913B
kibuzzard-63988507, kibuzzard-63988507#2: G***; kibuzzard-63988507

Connections:
3.3V: CONN1.2 (V+), CONN2.2 (V+), J1.1, U1#2.2 (3V3)
+3V3: C5#2.1, C6#2.1, C8.1, C13.1, C14.2, C15.2, C16.2, C17.1, C18.1, D3.2 (ANODE), D4.2 (A), D5.2 (A), D5#2.1 (A1), D6.2 (A), D7.2 (A), D8.2 (A), D9.2 (A), D10.2 (A), D11.2 (A), J1#2.2, J3#2.2, JP1.2 (B), L1.2, R11.1, R12.2, R14#2.2, R15.2, R16.1, R18.2, R24.2, TP3.1, U1.8 (V+), U2.15 (DVDD), U4.8 (V+), U5.16 (VCC), U7.1 (OUT2), U7.3 (EN2), U7.4 (EN1), U7.5 (IN), X1.4 (VDD)
/D+: J2.A6 (D+), J2.B6 (D+), R10#2.1, R12#2.1, U2#2.1, U2#2.6 (A)
/D-: J2.A7 (D-), J2.B7 (D-), R11#2.2, R13#2.1, U2#2.3, U2#2.4 (B)
/EN: C1#2.2, R14#2.1, U1#2.3 (EN)
/KeepAlive: D4#2.2 (A), U1#2.39 (GPIO1/TOUCH1/ADC1_CH0)
/SCL: CONN1.4 (SCL), CONN2.4 (SCL)
/SDA: CONN1.3 (SDA), CONN2.3 (SDA)
/Switched_Power: C2#2.1, D6#2.1 (K), Q4.2 (S), U3.1 (EN), U3.4 (VIN)
/Trigger: JP1#2.3 (B), U1#2.38 (GPIO2/TOUCH2/ADC1_CH1)
/Trigger_Wake_Up/VBAT: BT1.1 (+), J3.1, Q2.2 (S), R4#2.1, R5.2, U5#2.3 (VBAT), X1#2.2, X2.2
/USB_D+: R12#2.2, U1#2.14 (GPIO20/U1CTS/ADC2_CH9/CLK_OUT1/USB_D+)
/USB_D-: R13#2.2, U1#2.13 (GPIO19/U1RTS/ADC2_CH8/CLK_OUT2/USB_D-)
GND: BT1.2 (-), C1.1, C1#2.1, C2#2.2, C6.1, C6#2.2, C7.1, C8.2, C10.1, C11.1, C13.2, C14.1, C15.1, C16.1, C17.2, C18.2, C19.1, C20.1, CONN1.1 (GND), CONN2.1 (GND), D2.1 (K), D5#2.2 (A2), H1.1, H2.1, J1.2, J1.MP (MountPin), J1#2.1, J3.2, J3#2.1, J4.1, R1.2, R2#2.2, R6.1, R8#2.1, R10#2.2, R11#2.1, R16#2.1, R17.1, U1.4 (V-), U1#2.1 (GND), U1#2.40 (GND), U1#2.41 (GND), U2.7 (REFN), U2.8 (AVSS), U2.9 (DVSS), U2#2.2 (GND), U2#2.5 (GND), U3.2 (GND), U4.4 (V-), U5.1 (A0), U5.2 (A1), U5.3 (A2), U5.8 (GND), U5#2.2 (VSS), U6.3 (GND), U6.5 (PGND), U7.2 (GND), X1.2 (GND)
unnamed: D1#2.2 (A), JP1#2.1 (A)
unnamed: D1#2.1 (K), JP2.2 (B), R3#2.1
unnamed: D2#2.1 (K), JP2.1 (A)
unnamed: D3#2.2 (A), R7#2.1
unnamed: D3#2.1 (K), Q3.1 (B), R8#2.2, R9#2.2
unnamed: D4#2.1 (K), R9#2.1
unnamed: J2.A5 (CC1), R2#2.1
unnamed: J2.B5 (CC2), R1.1
unnamed: J2.A1 (GND), J2.A12 (GND), J2.B1 (GND), J2.B12 (GND)
unnamed: JP1#2.2 (C), X1#2.1
unnamed: Q1#2.1 (B), R3#2.2
unnamed: Q1#2.3 (C), R5.1
unnamed: Q1#2.2 (E), R6.2, R7#2.2
unnamed: Q2.3 (D), Q4.3 (D), X2.1
unnamed: Q2.1 (G), Q3.3 (C), R4#2.2
unnamed: C5#2.2, R15.1, R16#2.2, U3.5 (FB)
unnamed: L1.1, U3.3 (SW)
unnamed: R17.2, U5#2.5 (PROG)
USB_pwr: D2#2.2 (A), D6#2.2 (A), J2.A4 (VBUS), J2.A9 (VBUS), J2.B4 (VBUS), J2.B9 (VBUS), Q4.1 (G), R18#2.2, U5#2.1 (CEN), U5#2.4 (VDD)
