LokiMetaSmith/handheld-scanner/(commit log)

2022-12-15 added recommended crystal layout to board
    [RoundScanner.kicad_pcb, adc.kicad_sch]
2023-06-06 Initial conversion and cleanup from a feather to an esp32s3
    added USB power
    Added switching 3.6-5v regulator
    updated schematic ground to use built in kicad libraries
    updated partially broken library references to eagle lib files
    added circuit simulator of trigger and wakeup simulation
    [ControllerBoard.kicad_pcb, ControllerBoard.kicad_sch, RoundScanner.kicad_pcb, Trigger_Wake_Up.kicad_sch]
2023-10-03 added footprint for MTSM2601SMF1-100
    [3405 Adafruit HUZZAH32 ESP32 Feather.step, B2B-EH-A_LF__SN_.stp, B8B-PH-SM4-TB_LF__SN_.stp, ControllerBoard.kicad_pcb, ControllerBoard.kicad_sch, PinHeader_1x04_P2.54mm_Vertical.step, PinHeader_1x08_P2.54mm_Vertical.step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]
2023-10-03 removed defunct 3d model from MTSM2601SMF1-100 Signed-off-by: lokimetasmith <lokimail@gmail.com>
    [RoundScanner.kicad_pcb]
2023-10-30 lots of changes, added footprints, fixed broken schemaitcs, fixed kicad 7.0 issues
    [RoundScanner.kicad_pcb, RoundScanner.kicad_sch, adc.kicad_sch, led.kicad_sch, mcu.kicad_sch, power.kicad_sch, sensor.kicad_sch]
2023-10-30 second pass on controller rework
    [ControllerBoard.kicad_pcb, ControllerBoard.kicad_sch]
2023-11-01 updated routing on control board, added led pcb template
    [ControllerBoard.kicad_pcb, ControllerBoard.kicad_sch, LEDBoard.kicad_pcb, LEDBoard.kicad_sch]
2023-11-10 added linear regulator for reference voltage
    [RoundScanner.kicad_pcb, RoundScanner.kicad_sch, mcu.kicad_sch, power.kicad_sch, sensor.kicad_sch]
2023-11-10 added options for using internal adc, external adc, or 3.3v
    [RoundScanner.kicad_pcb, adc.kicad_sch, power.kicad_sch, sensor.kicad_sch]
2023-11-10 updated pcb silkscreen date
    [RoundScanner.kicad_pcb]
2023-11-20 updated schematic, and layout, updated bom, fully converted to 3.3v for Voltage input only
    [RoundScanner-B_Cu.gbr, RoundScanner-B_Mask.gbr, RoundScanner-B_Paste.gbr, RoundScanner-B_Silkscreen.gbr, RoundScanner-Edge_Cuts.gbr, RoundScanner-F_Cu.gbr, RoundScanner-F_Mask.gbr, RoundScanner-F_Paste.gbr]
2023-11-20 updated red power led to a common lower value, dimmer power led shouldn't be an issue
    [adc.kicad_sch, mcu.kicad_sch, power.kicad_sch]
2023-11-20 added missing QUICC connector
    [power.kicad_sch]
2023-11-21 added decoupling capactitors, added footprint for 3d model, need to verify new footprint
    [RoundScanner.kicad_pcb, adc.kicad_sch, mcu.kicad_sch, power.kicad_sch, sensor.kicad_sch]
2023-11-22 cleared all DRC errors
    [RoundScanner.kicad_pcb, mcu.kicad_sch, power.kicad_sch]
2023-11-27 as ordered 11/27/2023 from JLCPCB
    Updated silk on RoundScanner, minor changes,
    major changes on control board, cleaned up foot prints, nudged parts around
    control board not ready for release yet
    [ControllerBoard.kicad_pcb, ControllerBoard.kicad_sch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]
